Yutu0k/Flip-Annimator/1_Mechanical/Flaps-Drum-Inside.step

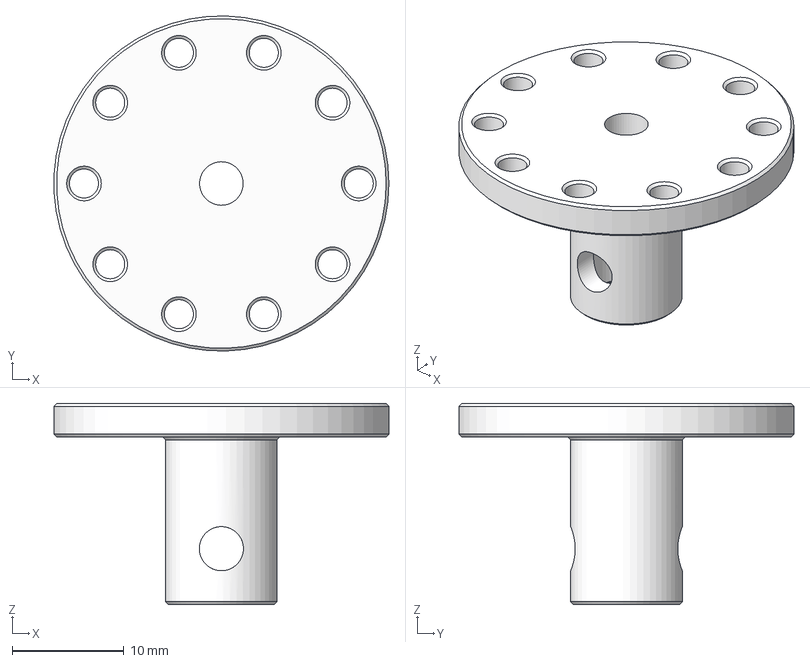
[picture p3: CAD file, 2024-02-12]
1_Mechanical/Flaps-Drum-Inside.step
30.0 x 30.0 x 18.0 mm
