Yutu0k/Flip-Annimator/1_Mechanical/Flap.step

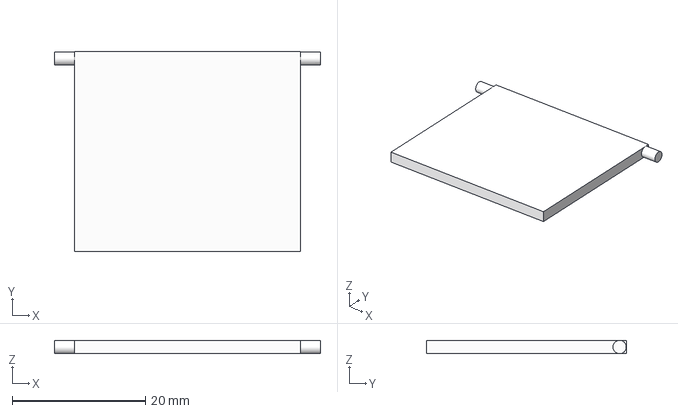
[picture p4: CAD file, 2024-02-12]
1_Mechanical/Flap.step
40.0 x 30.0 x 2.00 mm
