Yutu0k/Flip-Annimator/1_Mechanical/Flaps-Drum-Outside.step

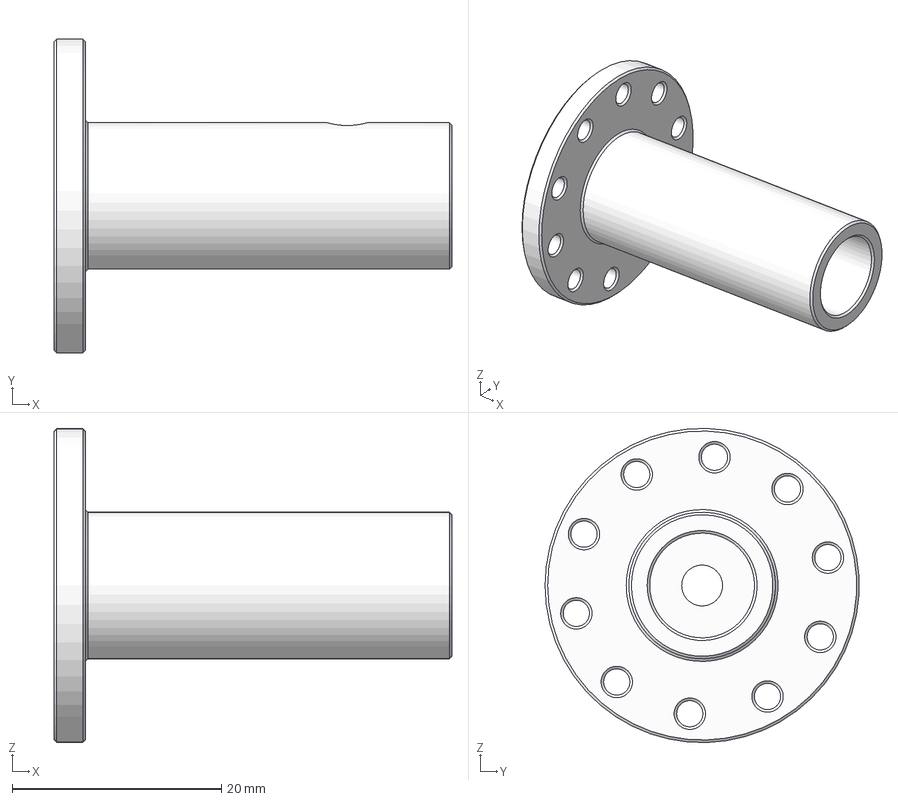
[picture p5: CAD file, 2024-02-12]
1_Mechanical/Flaps-Drum-Outside.step
38.0 x 30.0 x 30.0 mm
