Yutu0k/Flip-Annimator/1_Mechanical/BackCover.step

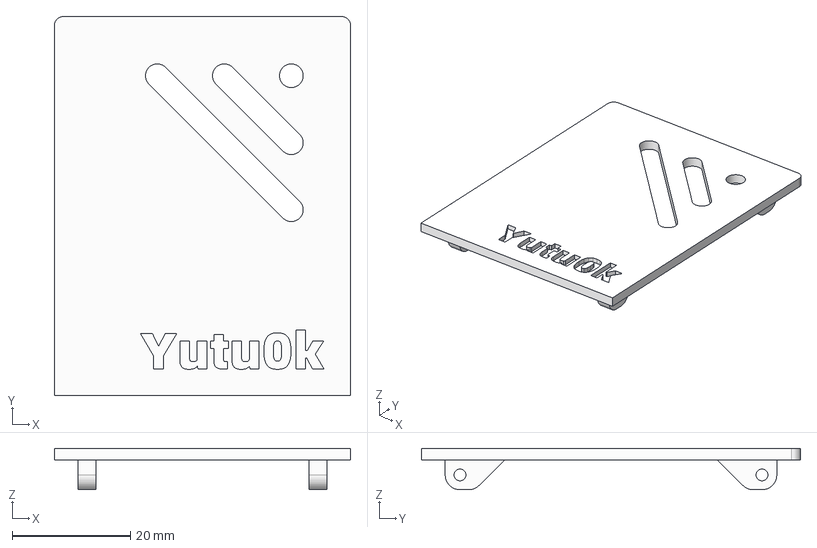
[picture p6: CAD file, 2024-02-12]
1_Mechanical/BackCover.step
50.0 x 64.0 x 7.00 mm
