Yutu0k/Flip-Annimator/1_Mechanical/Shell.step

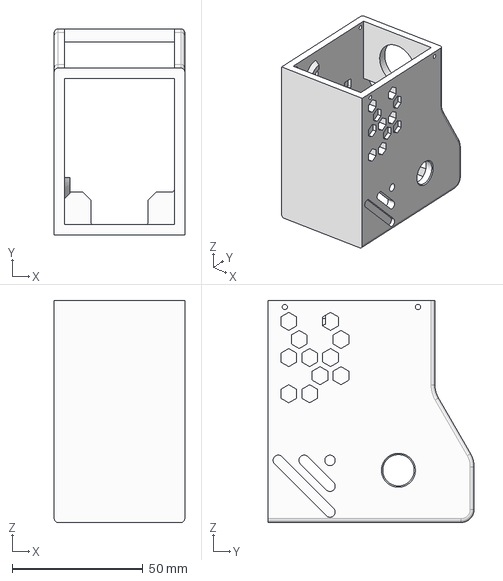
[picture p7: CAD file, 2024-02-12]
1_Mechanical/Shell.step
50.0 x 79.0 x 85.0 mm
