Yutu0k/Flip-Annimator/1_Mechanical/Stepper_28BYJ-48.stp

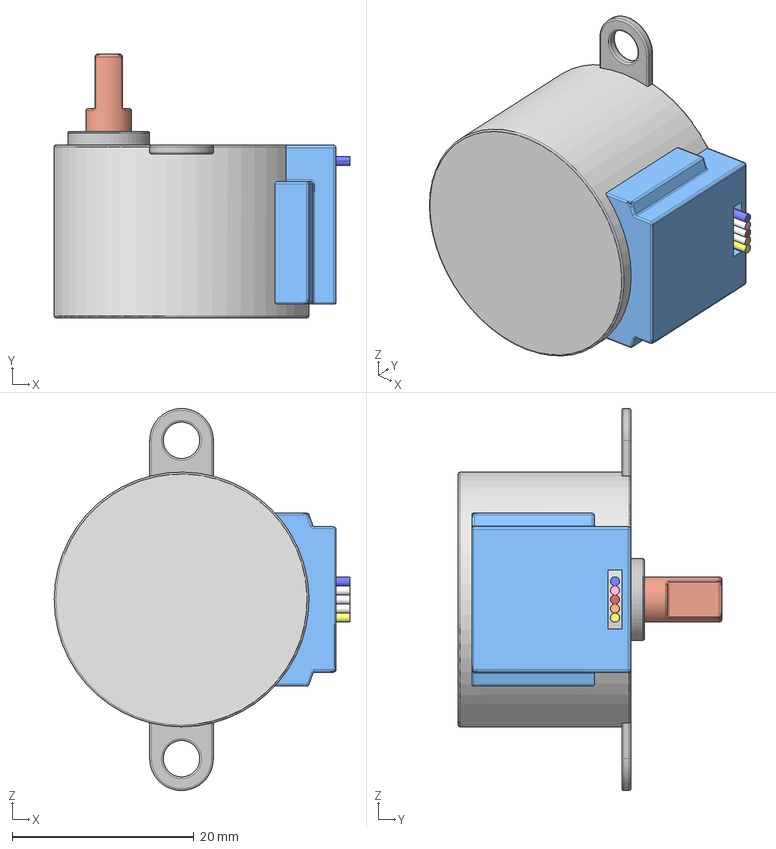
[picture p8: CAD file, 2024-02-12]
1_Mechanical/Stepper_28BYJ-48.stp
32.5 x 29.0 x 42.0 mm
