Yutu0k/Flip-Annimator/(list of files, cad)

Other CAD files:
0_Docs/ULN2003 步进电机扩展板资料/减速/main.OBJ
0_Docs/ULN2003 步进电机扩展板资料/加速/main.OBJ
0_Docs/ULN2003 步进电机扩展板资料/正反转/main.OBJ
