Yutu0k/Flip-Annimator/2_Firmware/Annimation Flipper/src/config.h

#ifndef CONFIG_H
#define CONFIG_H

#include <Arduino.h>
#include <CheapStepper.h>
#include <Button2.h>

/*********Pins Definition**********/
#define STEPMOTOR_IN_1 6
#define STEPMOTOR_IN_2 7
#define STEPMOTOR_IN_3 8
#define STEPMOTOR_IN_4 9
#define Button_Pin 5


#endif
